machineroom/SCL4/DSA2IH00216994.pdf

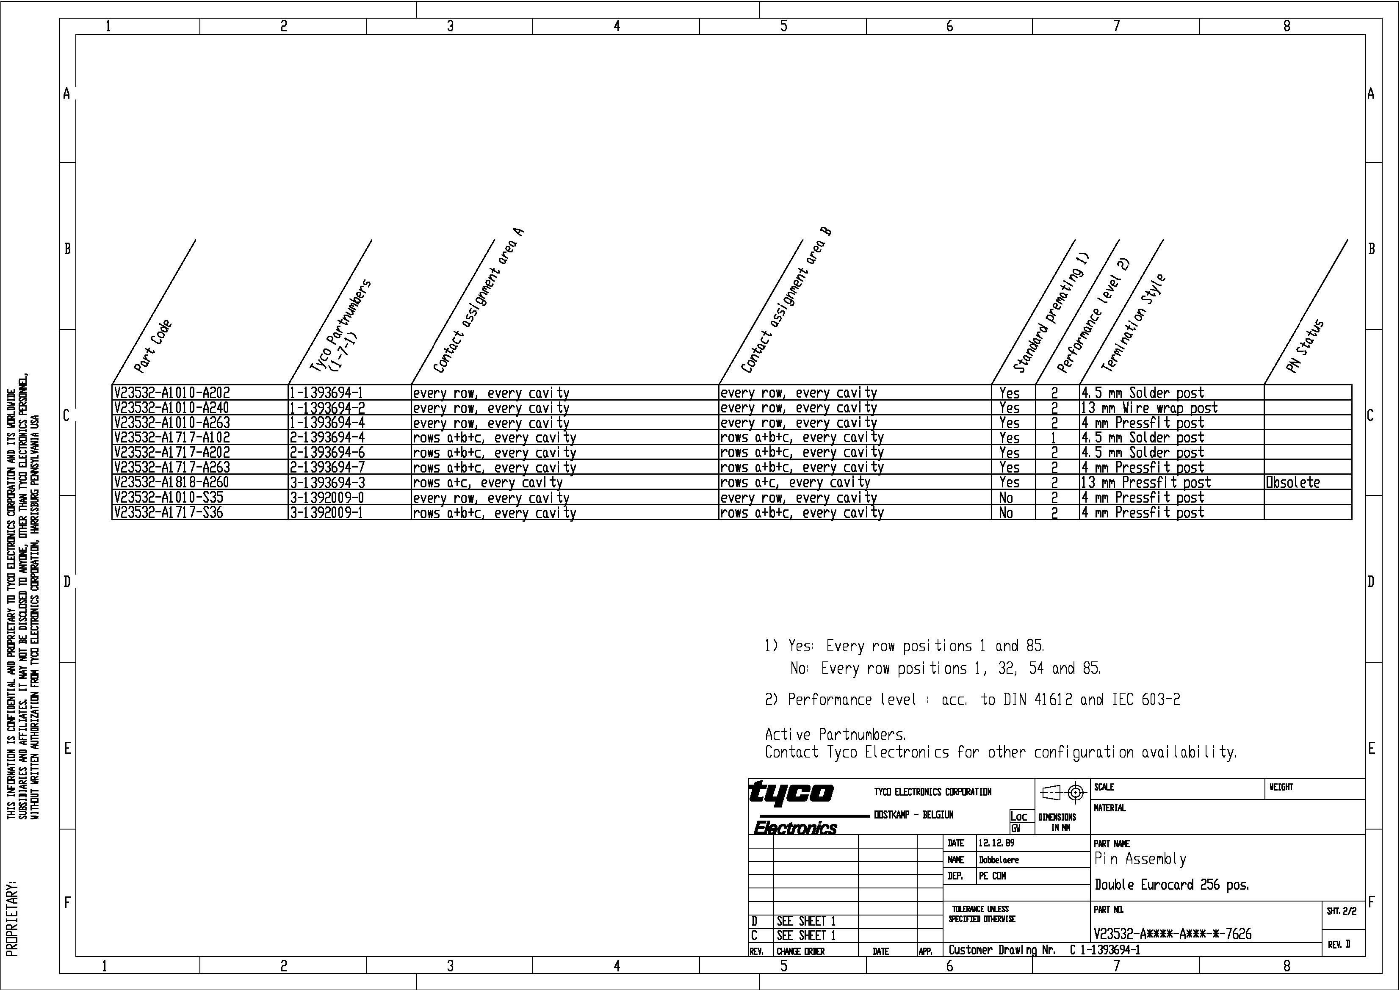
[picture p1: page 1]
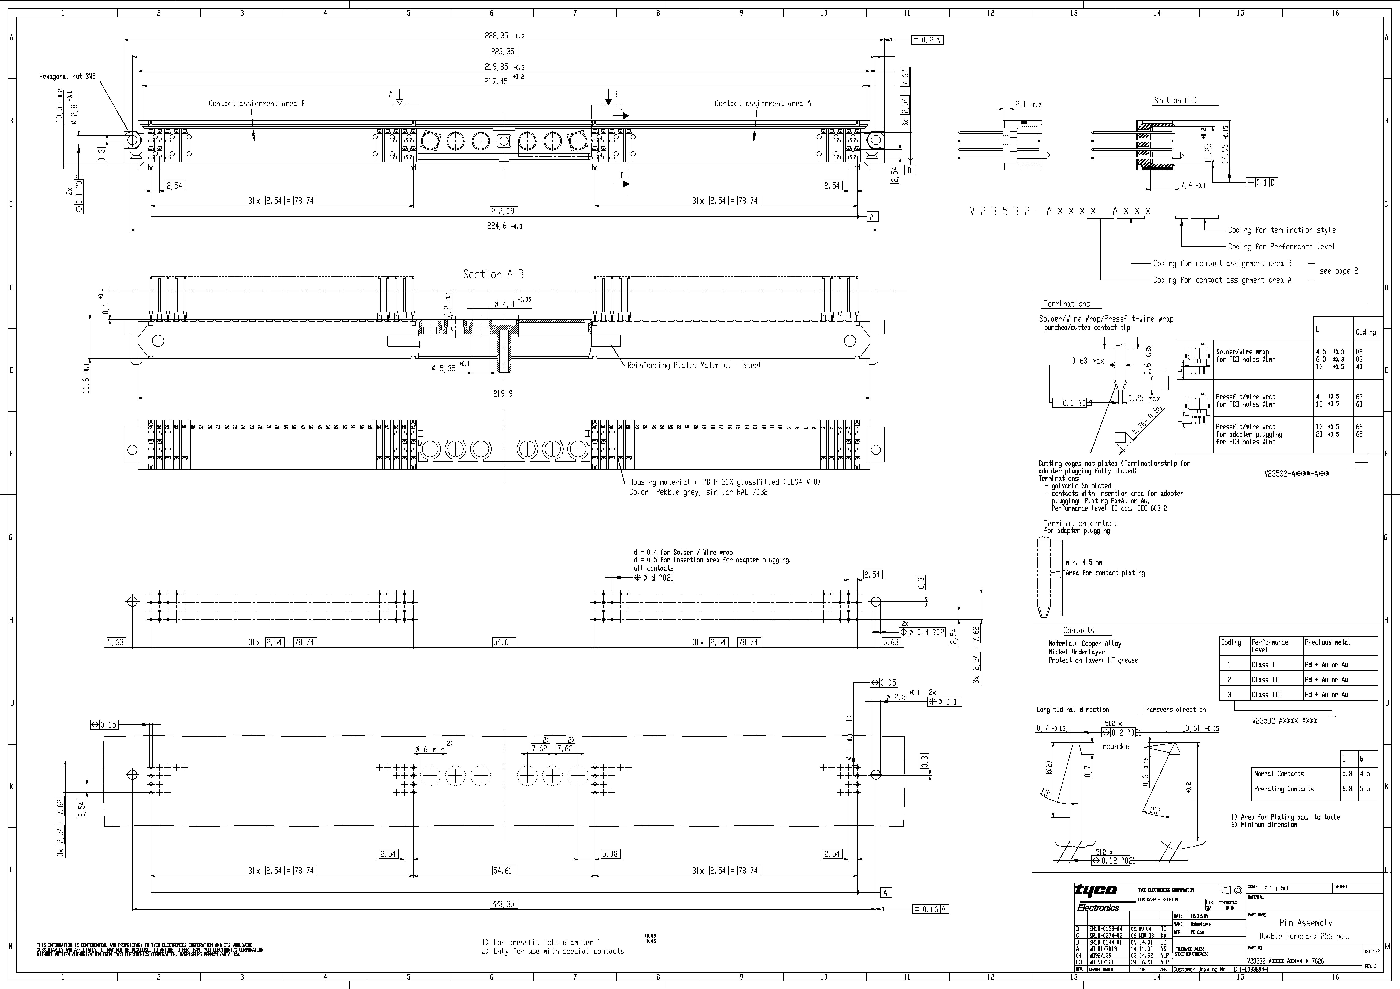
[picture p2: page 2]
