machineroom/SCL4/SCL4.kicad_pcb

## KiCad design SCL4.kicad_pcb (2023-01-14)

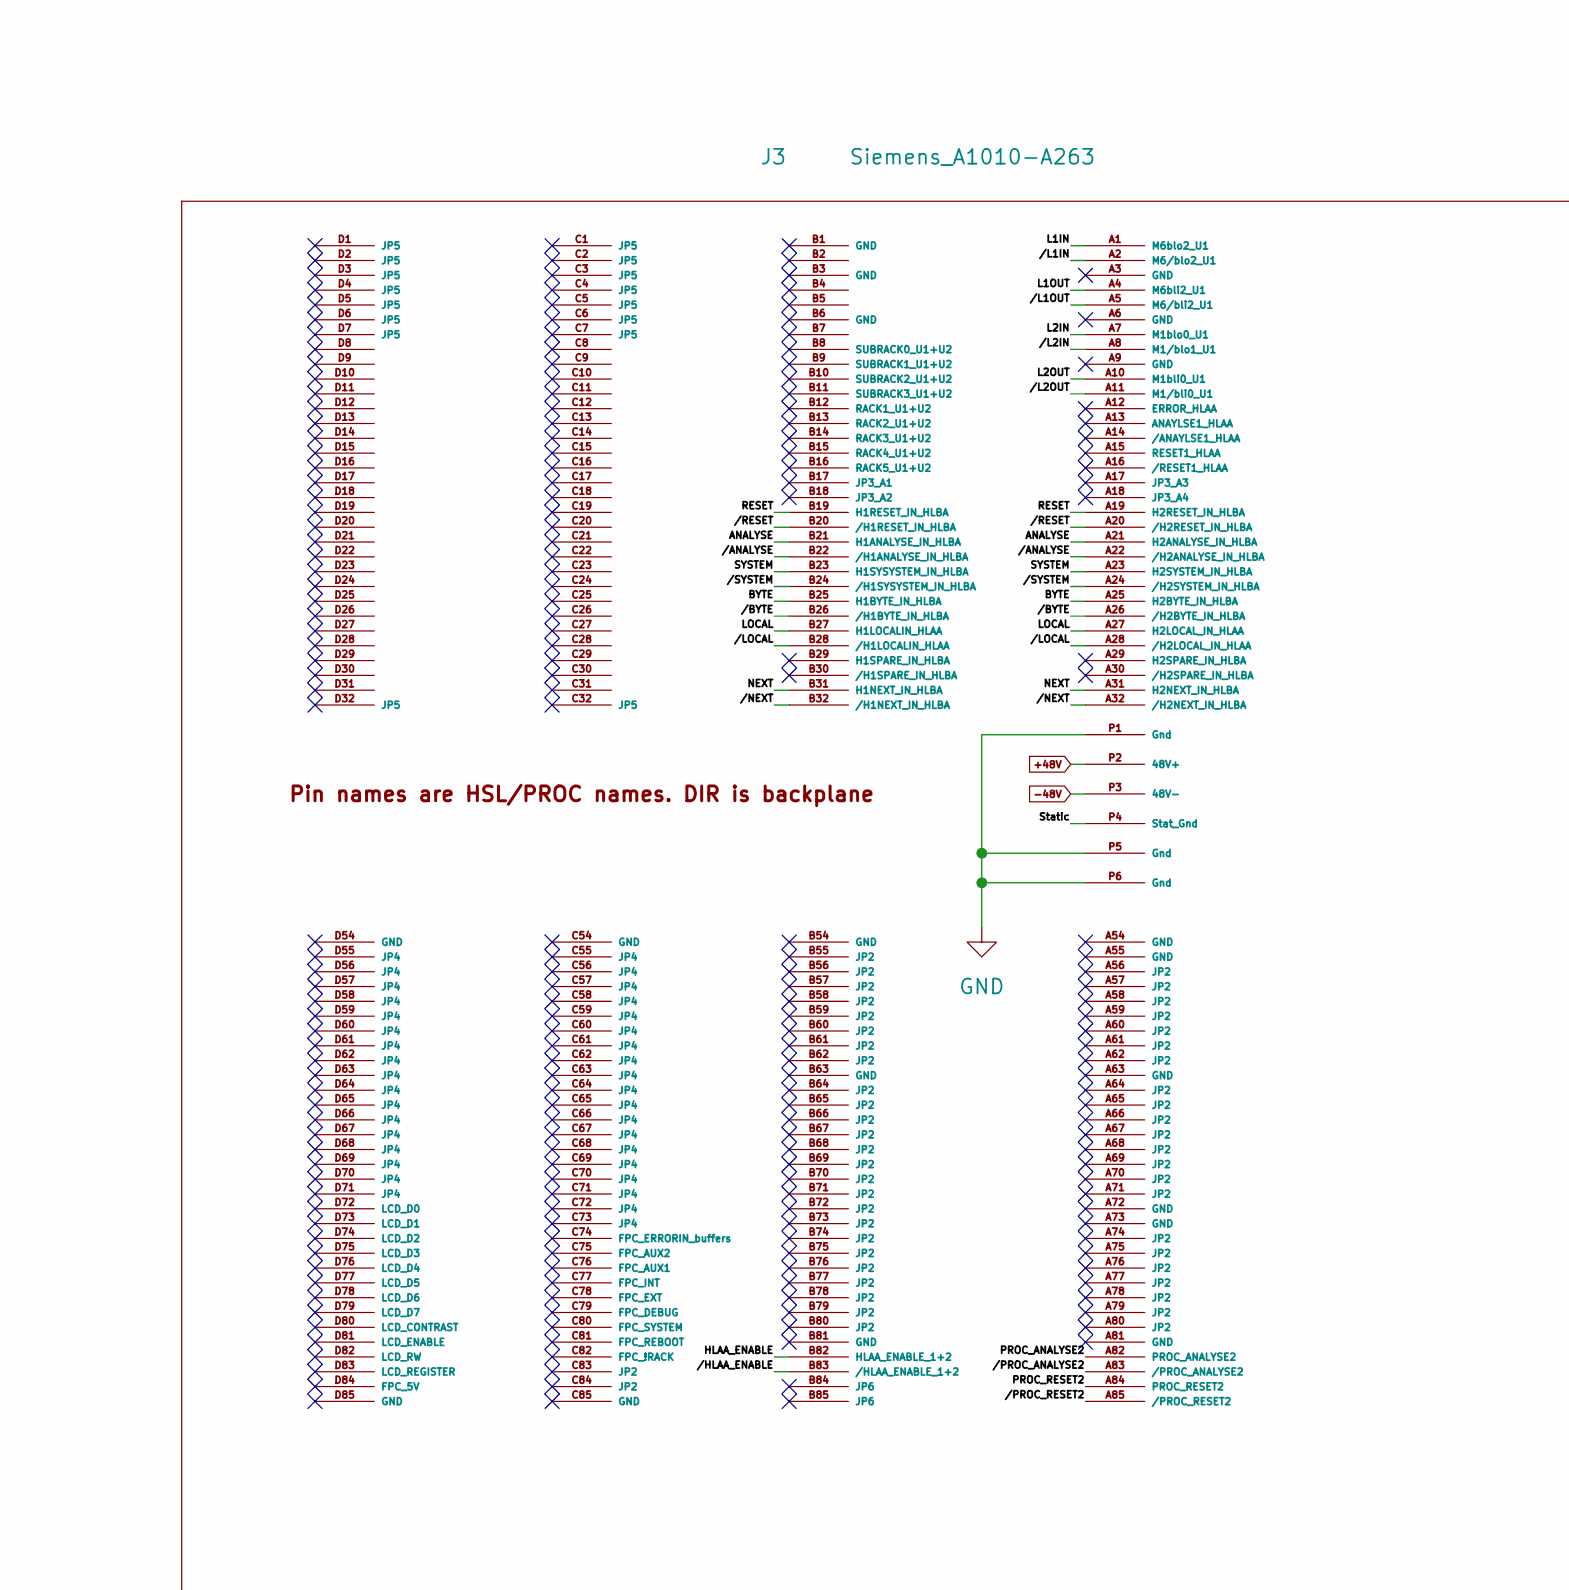
[picture p3: schematic SCL4.kicad_sch, part in row 1, column 1]

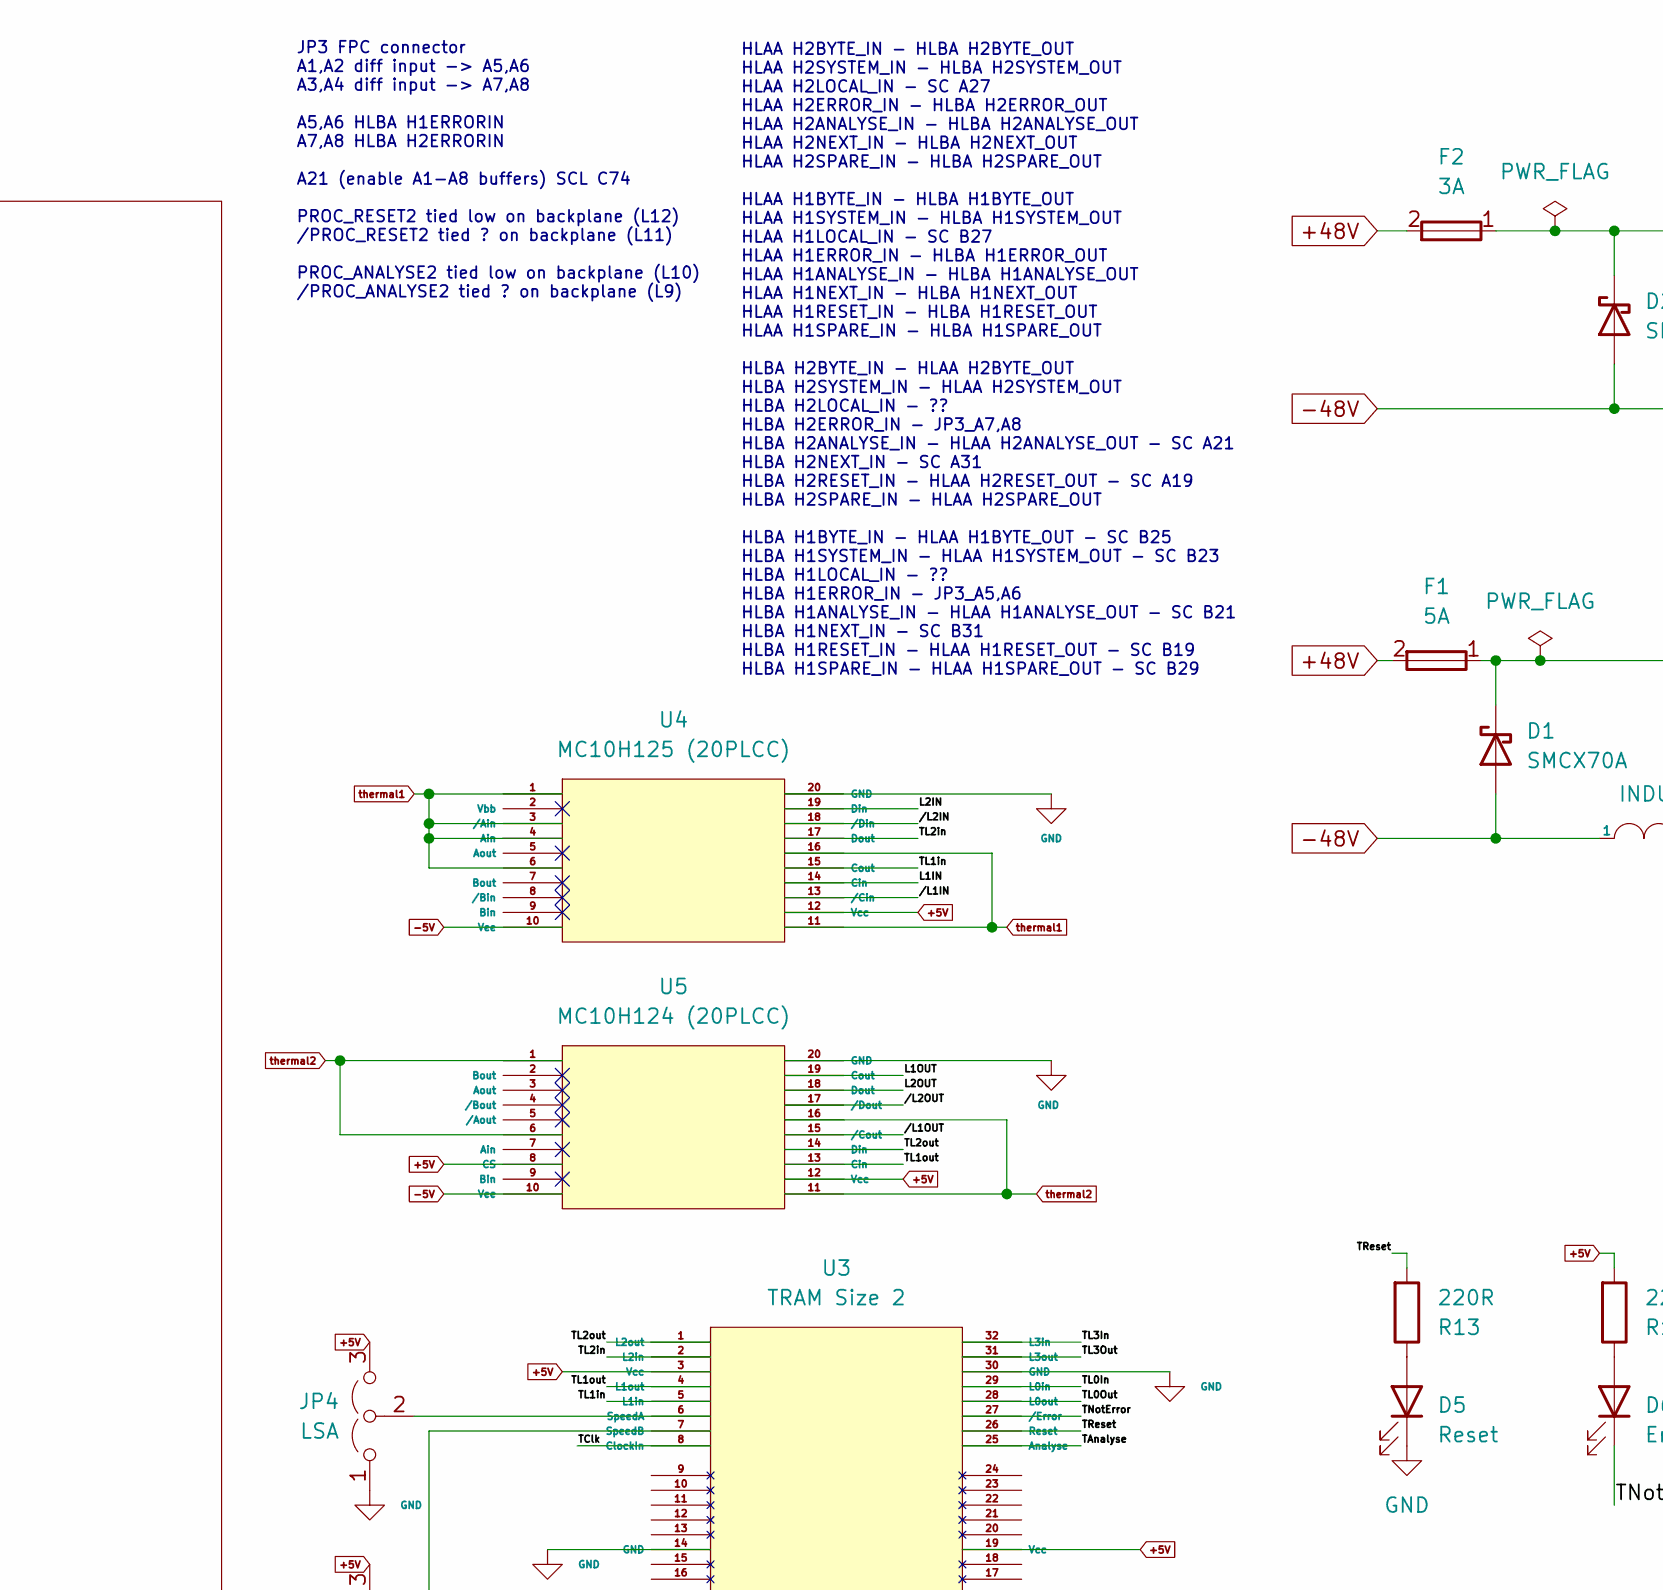
[picture p4: schematic SCL4.kicad_sch, part in row 1, column 2]

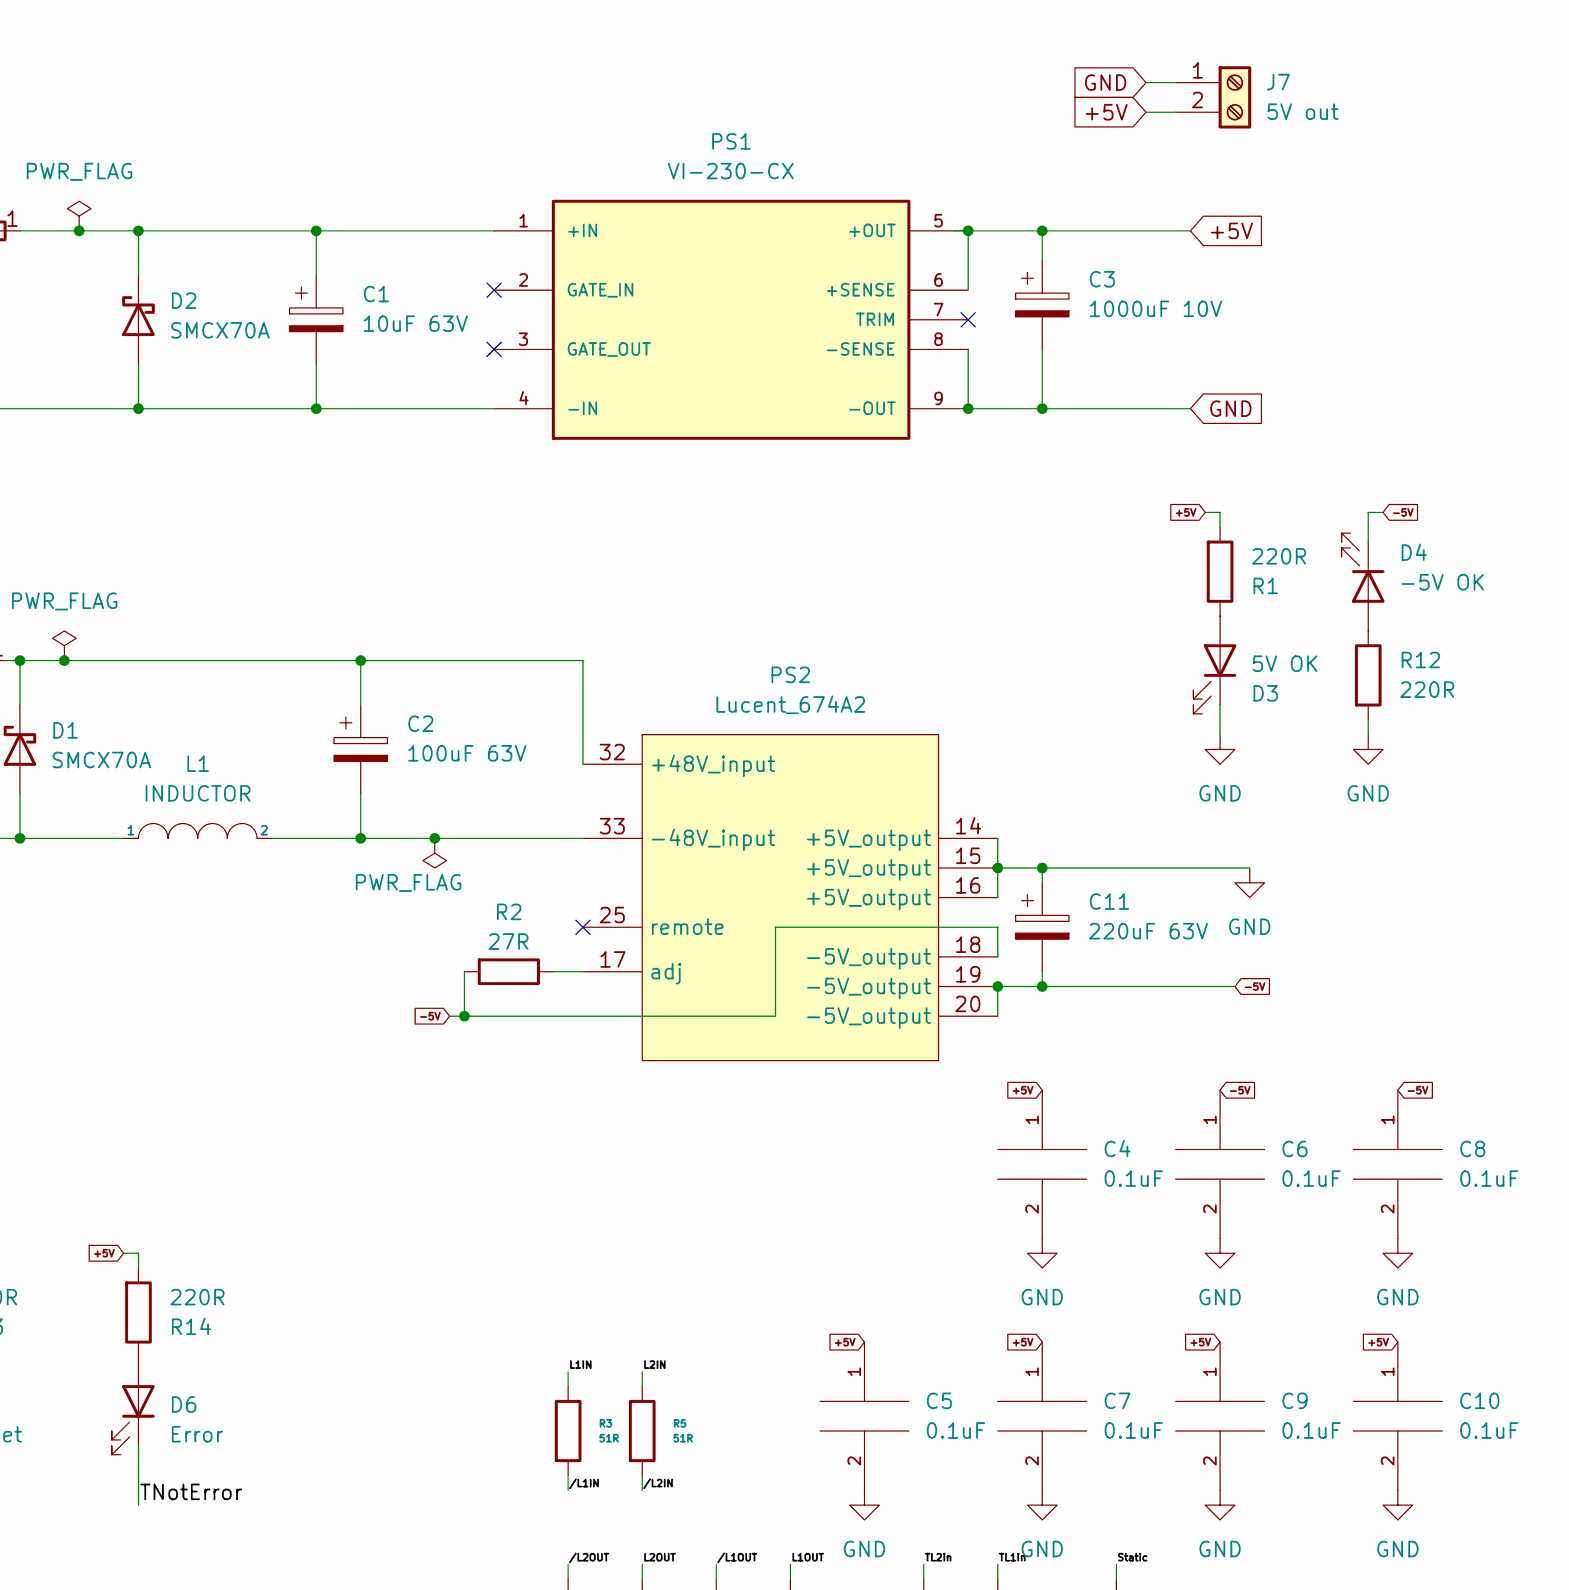
[picture p5: schematic SCL4.kicad_sch, part in row 1, column 3]

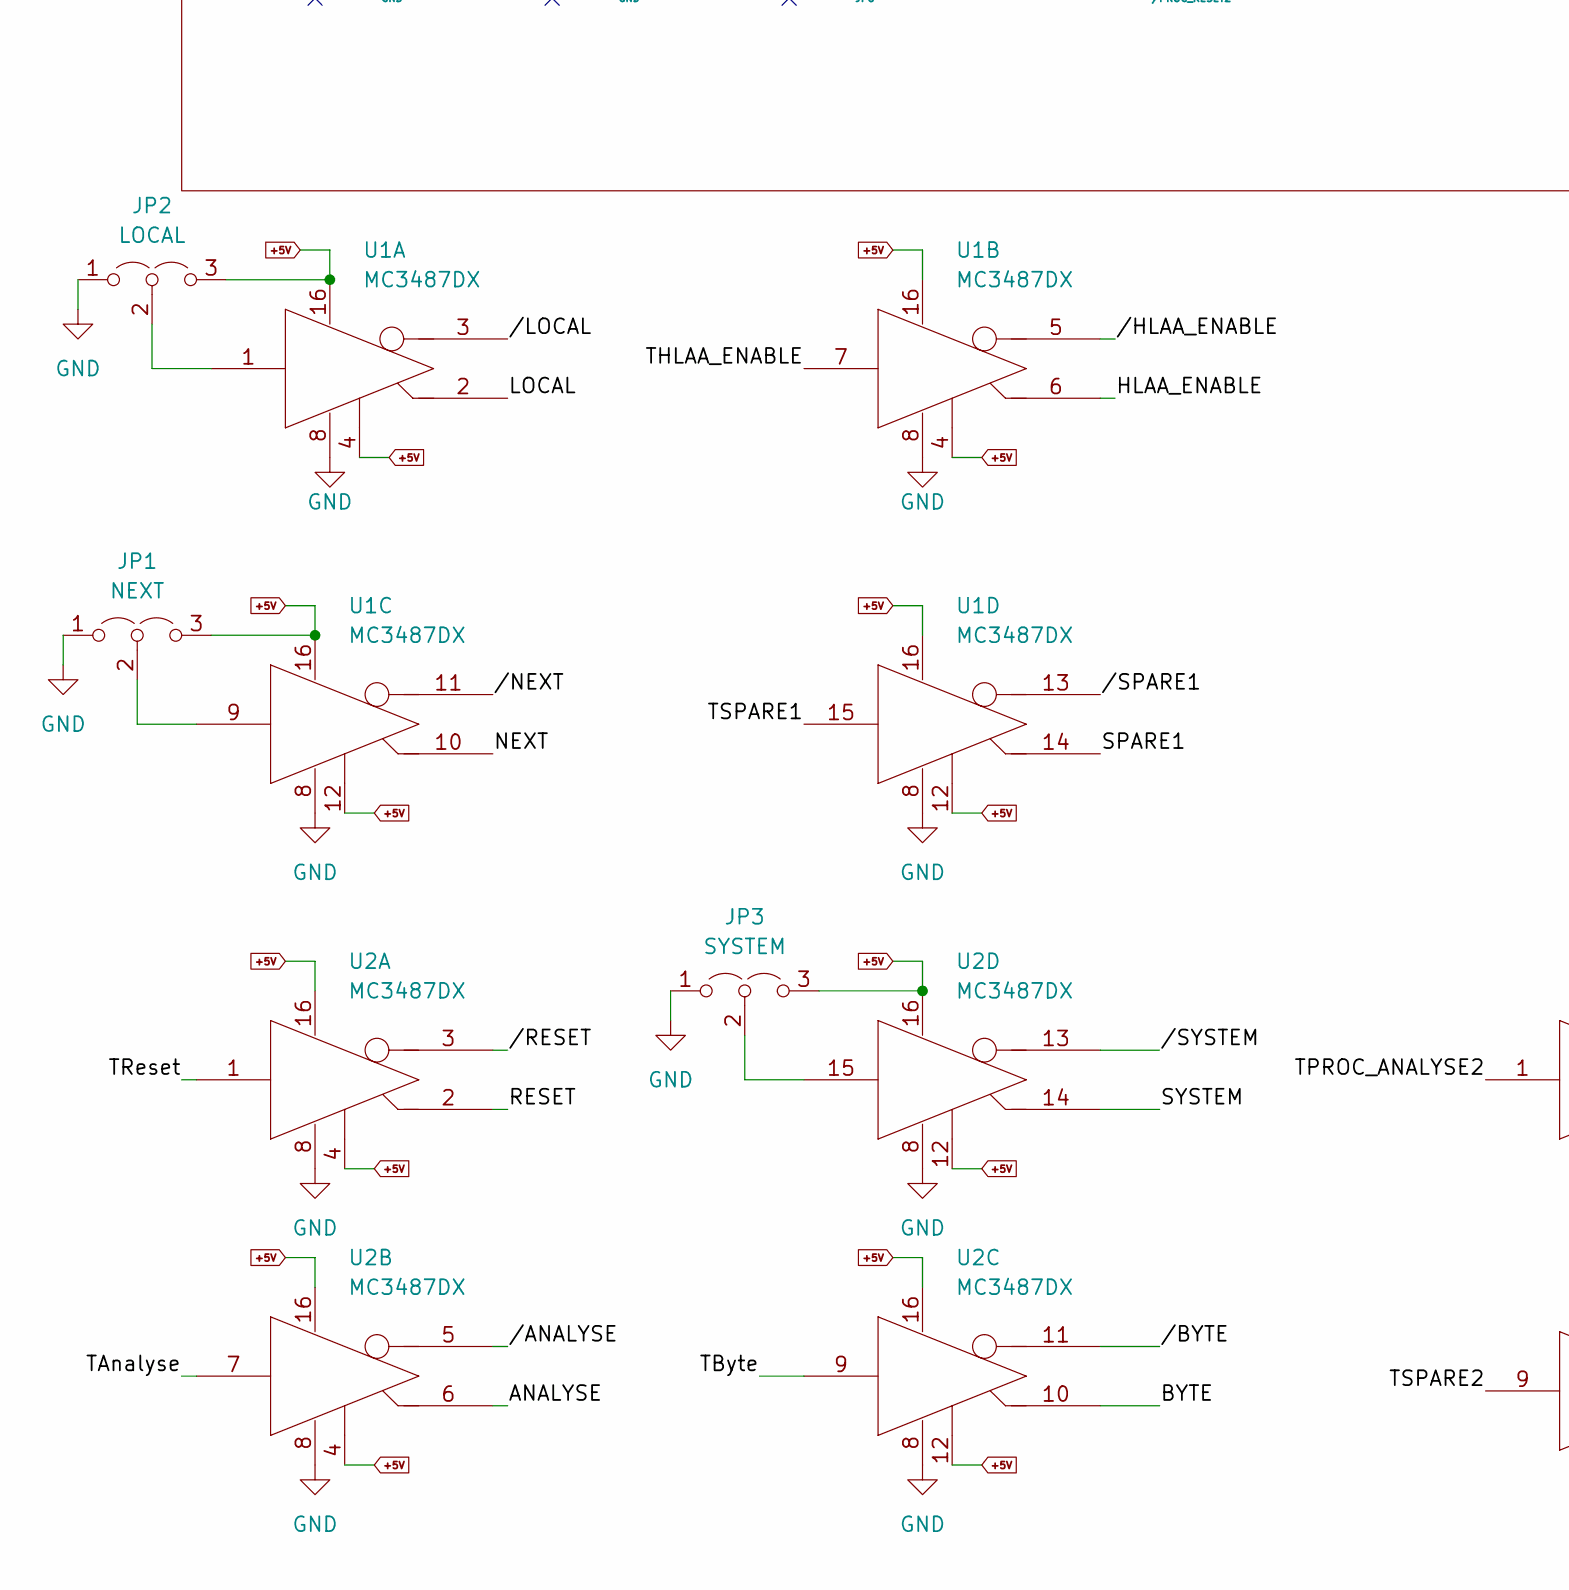
[picture p6: schematic SCL4.kicad_sch, part in row 2, column 1]

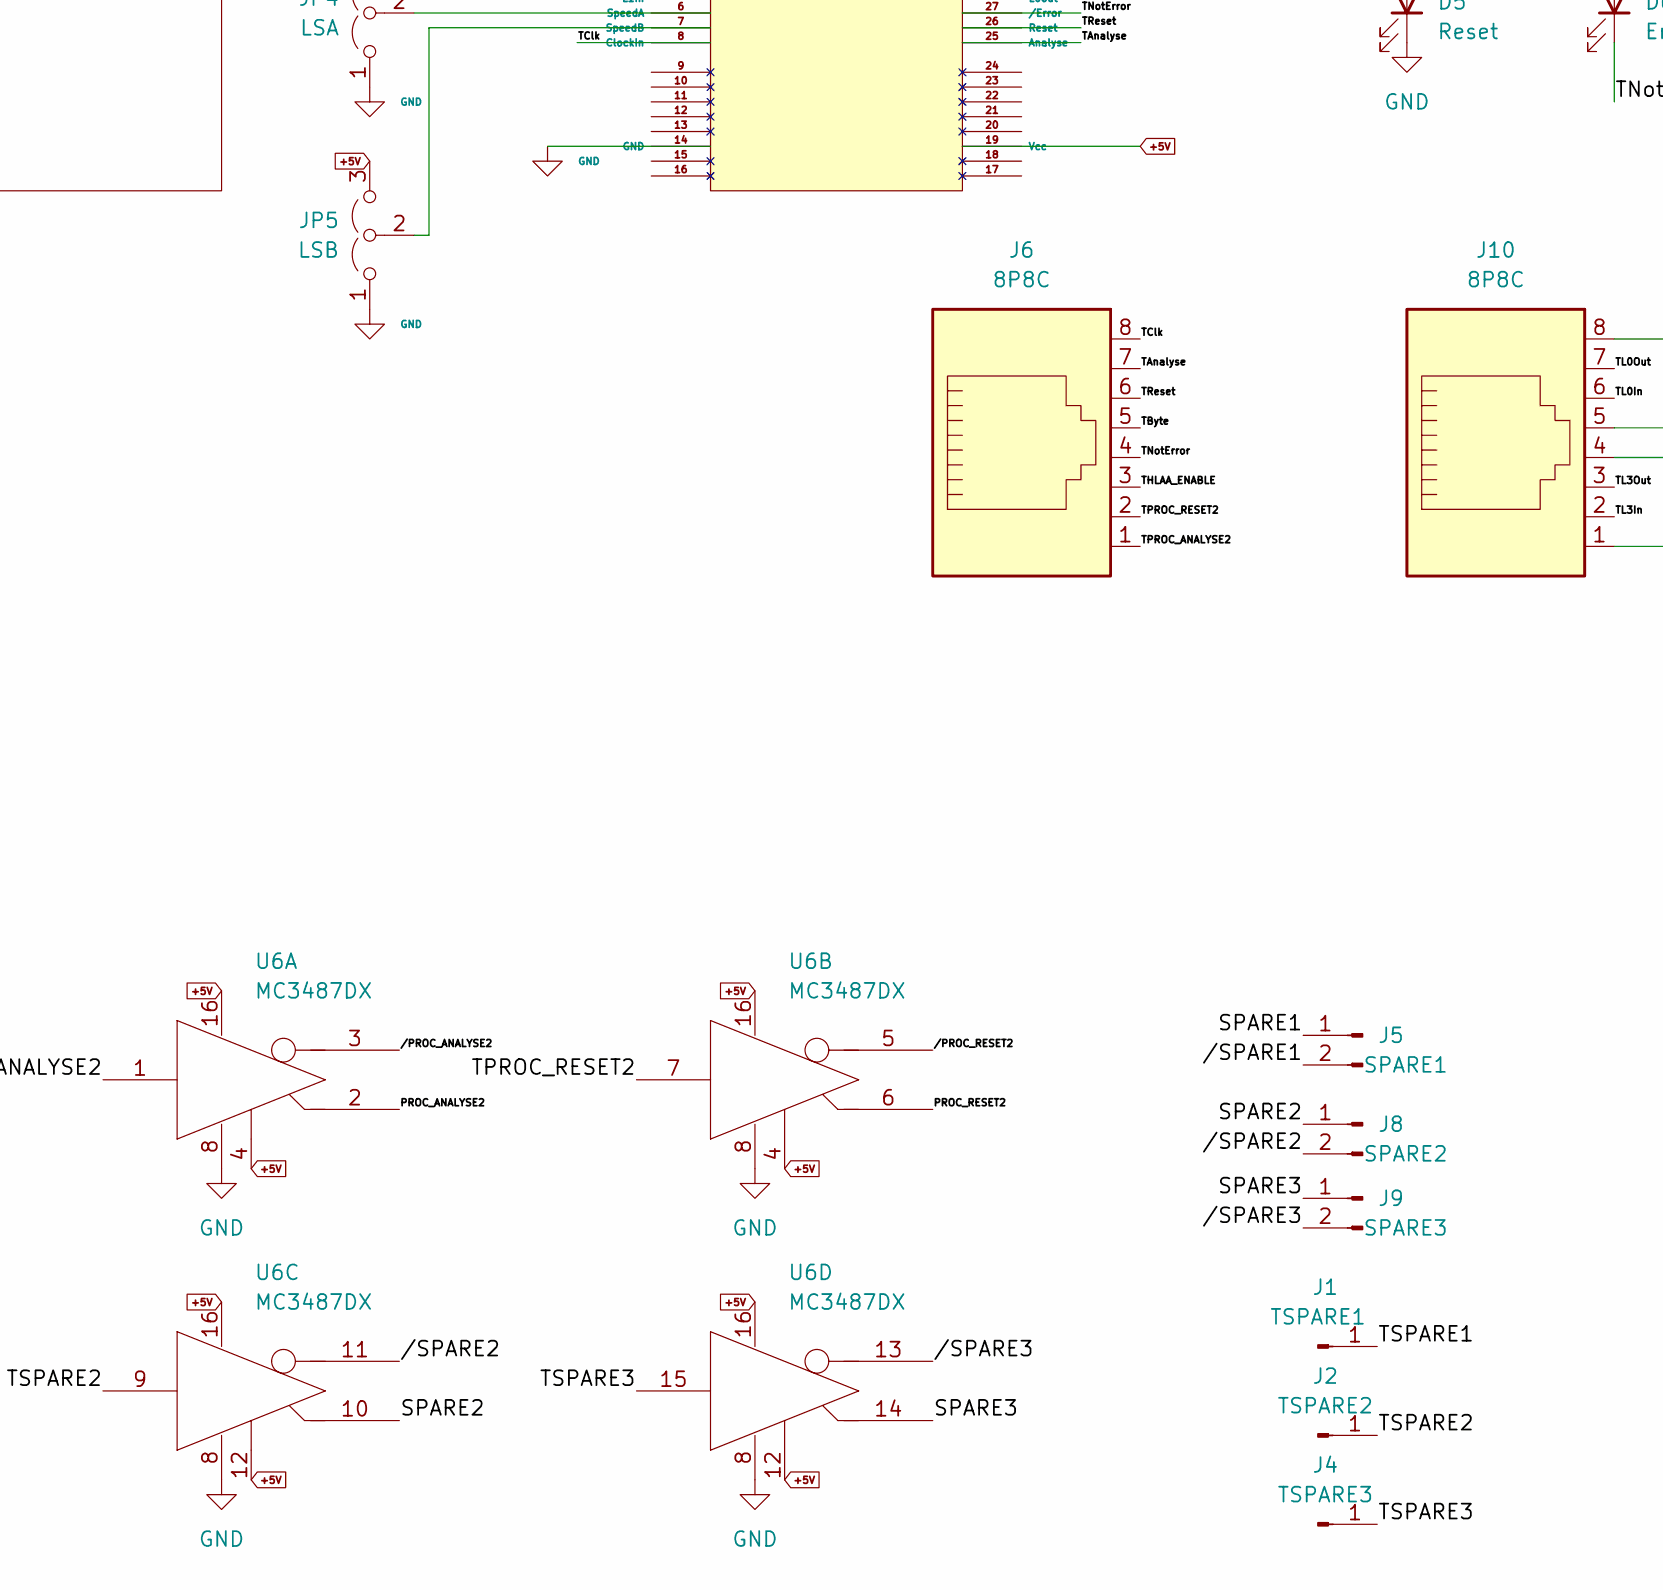
[picture p7: schematic SCL4.kicad_sch, part in row 2, column 2]

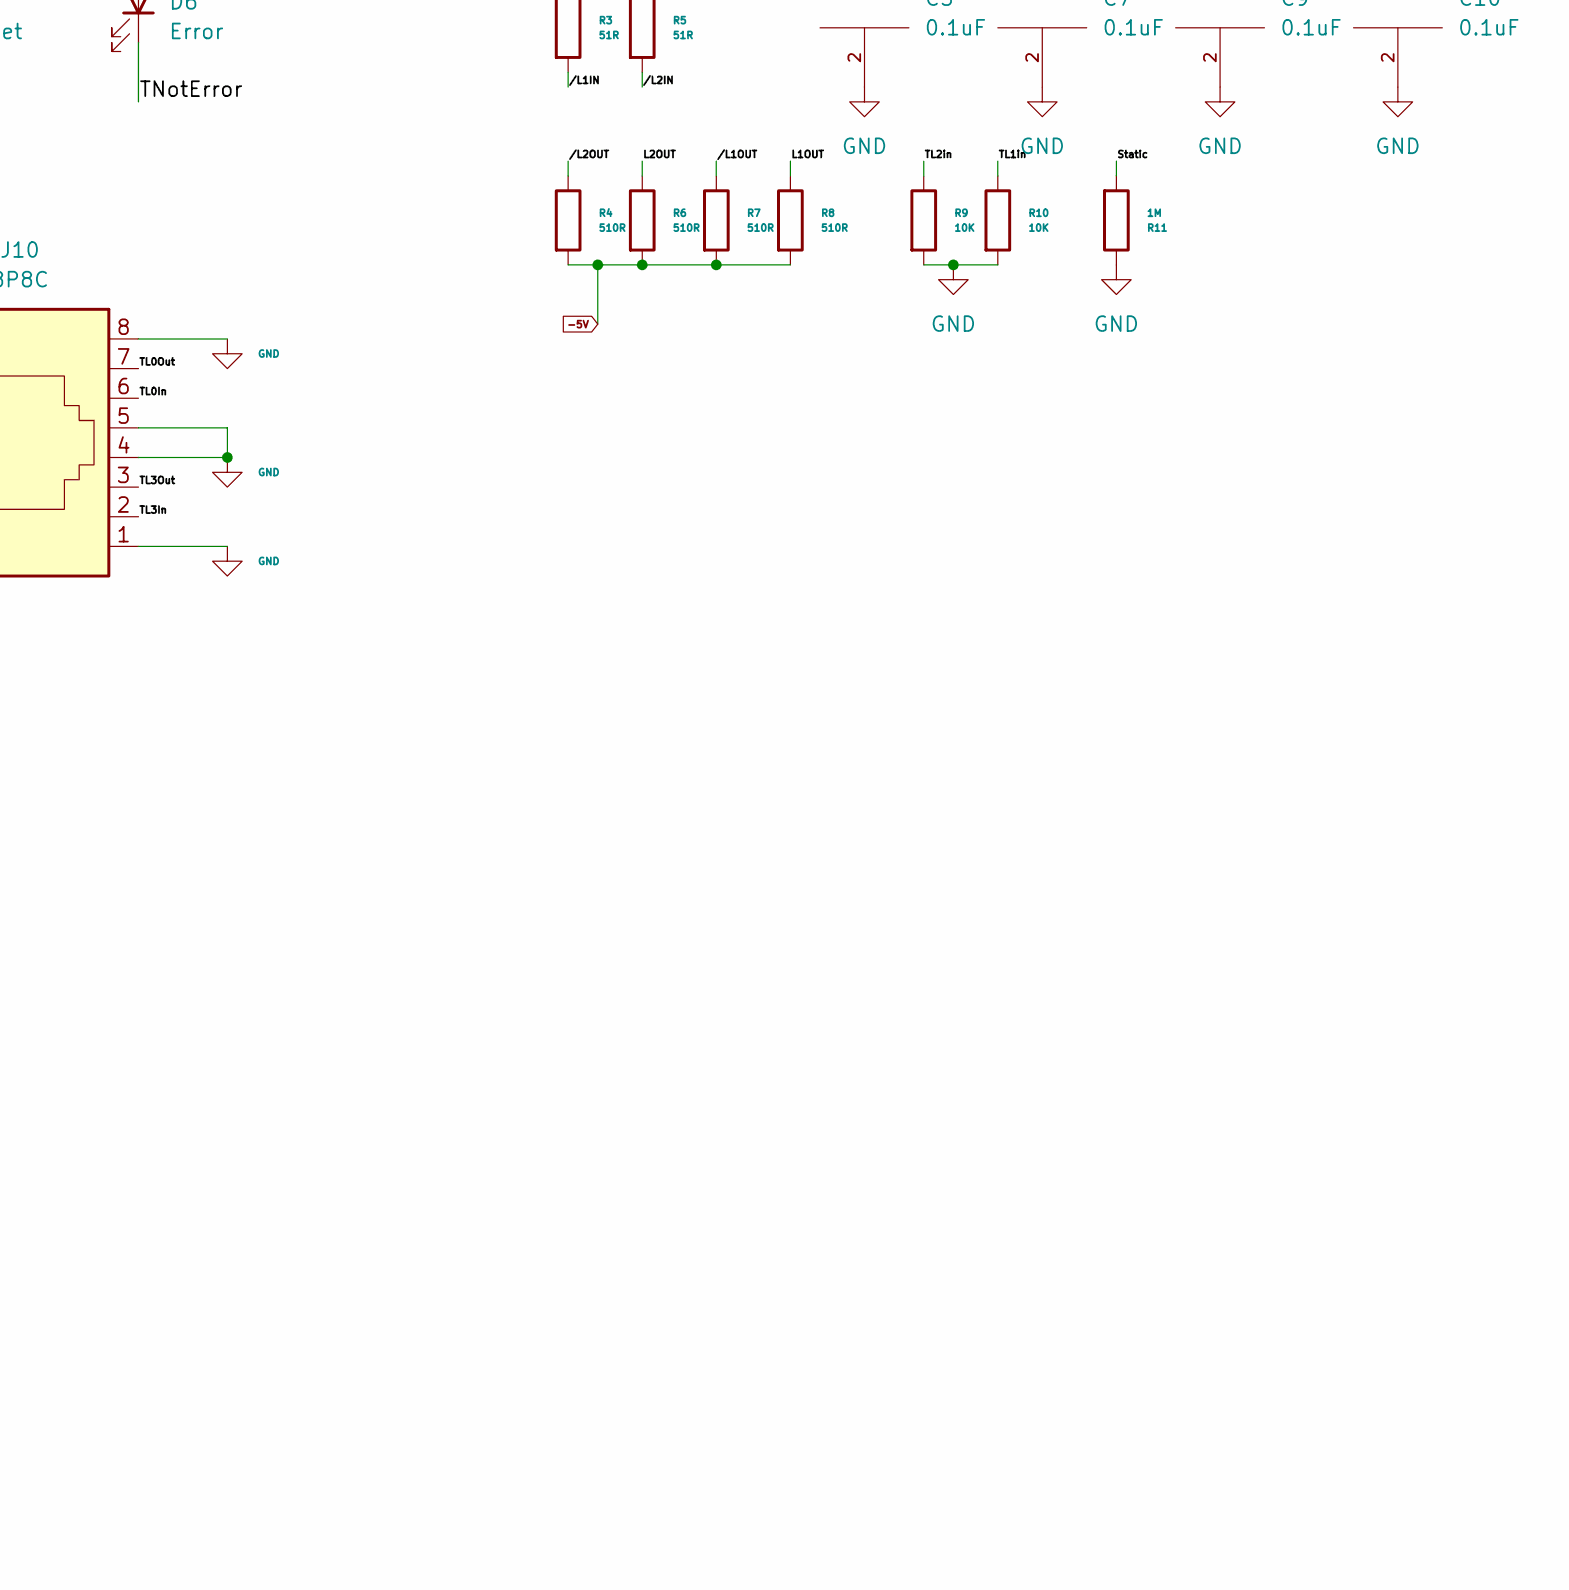
[picture p8: schematic SCL4.kicad_sch, part in row 2, column 3]

Parts:
C1: 10uF 63V; CP_Radial_D5.0mm_P2.50mm
C2: 100uF 63V; CP_Radial_D10.0mm_P5.00mm
C3: 1000uF 10V; C_Radial_D12.5mm_H20.0mm_P5.00mm
C4, C5, C6, C7, C8, C9, C10: 0.1uF; C_0402_1005Metric_Pad0.74x0.62mm_HandSolder
C11: 220uF 63V; C_Radial_D8.0mm_H11.5mm_P3.50mm
D1, D2: SMCX70A; D_SMC_Handsoldering
D3: 5V OK; LED_Rectangular_W5.0mm_H2.0mm
D4: -5V OK; LED_Rectangular_W5.0mm_H2.0mm
D5: Reset; LED_Rectangular_W5.0mm_H2.0mm
D6: Error; LED_Rectangular_W5.0mm_H2.0mm
F1: 5A; BUSSMAN SFT-1
F2: 3A; BUSSMAN SFT-1
J1: TSPARE1; PinHeader_1x01_P2.54mm_Vertical
J2: TSPARE2; PinHeader_1x01_P2.54mm_Vertical
J3: Siemens_A1010-A263; Siedecon 256+6
J4: TSPARE3; PinHeader_1x01_P2.54mm_Vertical
J5: SPARE1; PinHeader_1x02_P2.54mm_Vertical
J6, J10: 8P8C; RJ45_Ninigi_GE
J7: 5V out; TerminalBlock_bornier-2_P5.08mm
J8: SPARE2; PinHeader_1x02_P2.54mm_Vertical
J9: SPARE3; PinHeader_1x02_P2.54mm_Vertical
JP1: NEXT; PinHeader_1x03_P2.54mm_Vertical
JP2: LOCAL; PinHeader_1x03_P2.54mm_Vertical
JP3: SYSTEM; PinHeader_1x03_P2.54mm_Vertical
JP4: LSA; PinHeader_1x03_P2.54mm_Vertical
JP5: LSB; PinHeader_1x03_P2.54mm_Vertical
L1: INDUCTOR; L_Axial_L12.8mm_D5.8mm_P20.32mm_Horizontal_Fastron_HBCC
PS1: VI-230-CX; vicor vi230cx; PARTREV 3.9
PS2: Lucent_674A2; Lucent 674A2
R1, R12, R13, R14: 220R; R_1206_3216Metric_Pad1.30x1.75mm_HandSolder
R2: 27R; R_1206_3216Metric_Pad1.30x1.75mm_HandSolder
R3, R5: 51R; R_1206_3216Metric_Pad1.30x1.75mm_HandSolder
R4, R6, R7, R8: 510R; R_1206_3216Metric_Pad1.30x1.75mm_HandSolder
R9, R10: 10K; R_1206_3216Metric_Pad1.30x1.75mm_HandSolder
R11: 1M; R_1206_3216Metric_Pad1.30x1.75mm_HandSolder
U1, U2, U6: MC3487DX; SOIC-16_3.9x9.9mm_P1.27mm
U3: TRAM Size 2; TRAM size 2
U4: MC10H125 (20PLCC); PLCC-20
U5: MC10H124 (20PLCC); PLCC-20

Connections:
+5V: C3.1, C4.1, C5.1, C7.1, C9.1, C10.1, J7.2, JP1.3 (B), JP2.3 (B), JP3.3 (B), JP4.3 (B), JP5.3 (B), PS1.5 (+OUT), PS1.6 (+SENSE), R1.2, R14.2, U1.4 (ENABLE), U1.12 (ENABLE), U1.16 (VCC), U2.4 (ENABLE), U2.12 (ENABLE), U2.16 (VCC), U3.3 (Vcc), U3.19 (Vcc), U4.12 (Vcc), U5.8 (CS), U5.12 (Vcc), U6.4 (ENABLE), U6.12 (ENABLE), U6.16 (VCC)
+48V: F1.2, F2.2, J3.P2 (48V+)
-5V: C6.1, C8.1, C11.2, D4.1 (K), PS2.18 (-5V_output), PS2.19 (-5V_output), PS2.20 (-5V_output), R2.2, R4.2, R6.2, R7.2, R8.2, U4.10 (Vee), U5.10 (Vee)
-48V: C1.2, D1.2 (A), D2.2 (A), J3.P3 (48V-), L1.1, PS1.4 (-IN)
/ANALYSE: J3.A21 (H2ANALYSE_IN_HLBA), J3.B21 (H1ANALYSE_IN_HLBA), U2.6 (OUT+)
/BYTE: J3.A25 (H2BYTE_IN_HLBA), J3.B25 (H1BYTE_IN_HLBA), U2.10 (OUT+)
/HLAA_ENABLE: J3.B82 (HLAA_ENABLE_1+2), U1.6 (OUT+)
/L1IN: J3.A1 (M6blo2_U1), R3.1, U4.14 (Cin)
/L1OUT: J3.A4 (M6bli2_U1), R8.1, U5.19 (Cout)
/L2IN: J3.A7 (M1blo0_U1), R5.1, U4.19 (Din)
/L2OUT: J3.A10 (M1bli0_U1), R6.1, U5.18 (Dout)
/LOCAL: J3.A27 (H2LOCAL_IN_HLAA), J3.B27 (H1LOCALIN_HLAA), U1.2 (OUT+)
/NEXT: J3.A31 (H2NEXT_IN_HLBA), J3.B31 (H1NEXT_IN_HLBA), U1.10 (OUT+)
/PROC_ANALYSE2: J3.A82 (PROC_ANALYSE2), U6.2 (OUT+)
/PROC_RESET2: J3.A84 (PROC_RESET2), U6.6 (OUT+)
/RESET: J3.A19 (H2RESET_IN_HLBA), J3.B19 (H1RESET_IN_HLBA), U2.2 (OUT+)
/SPARE1: J5.1, U1.14 (OUT+)
/SPARE2: J8.1, U6.10 (OUT+)
/SPARE3: J9.1, U6.14 (OUT+)
/SYSTEM: J3.A23 (H2SYSTEM_IN_HLBA), J3.B23 (H1SYSYSTEM_IN_HLBA), U2.14 (OUT+)
/Static: J3.P4 (Stat_Gnd), R11.2
/TAnalyse: J6.7, U2.7 (INPUT), U3.25 (Analyse)
/TByte: J6.5, U2.9 (INPUT)
/TClk: J6.8, U3.8 (ClockIn)
/THLAA_ENABLE: J6.3, U1.7 (INPUT)
/TL0In: J10.6, U3.29 (L0in)
/TL0Out: J10.7, U3.28 (L0out)
/TL1in: R10.1, U3.5 (L1in), U4.15 (Cout)
/TL1out: U3.4 (L1out), U5.13 (Cin)
/TL2in: R9.1, U3.2 (L2in), U4.17 (Dout)
/TL2out: U3.1 (L2out), U5.14 (Din)
/TL3In: J10.2, U3.32 (L3in)
/TL3Out: J10.3, U3.31 (L3out)
/TNotError: D6.1 (K), J6.4, U3.27 (/Error)
/TPROC_ANALYSE2: J6.1, U6.1 (INPUT)
/TPROC_RESET2: J6.2, U6.7 (INPUT)
/TReset: J6.6, R13.2, U2.1 (INPUT), U3.26 (Reset)
/TSPARE1: J1.1, U1.15 (INPUT)
/TSPARE2: J2.1, U6.9 (INPUT)
/TSPARE3: J4.1, U6.15 (INPUT)
//ANALYSE: J3.A22 (/H2ANALYSE_IN_HLBA), J3.B22 (/H1ANALYSE_IN_HLBA), U2.5 (OUT-)
//BYTE: J3.A26 (/H2BYTE_IN_HLBA), J3.B26 (/H1BYTE_IN_HLBA), U2.11 (OUT-)
//HLAA_ENABLE: J3.B83 (/HLAA_ENABLE_1+2), U1.5 (OUT-)
//L1IN: J3.A2 (M6/blo2_U1), R3.2, U4.13 (/Cin)
//L1OUT: J3.A5 (M6/bli2_U1), R7.1, U5.15 (/Cout)
//L2IN: J3.A8 (M1/blo1_U1), R5.2, U4.18 (/Din)
//L2OUT: J3.A11 (M1/bli0_U1), R4.1, U5.17 (/Dout)
//LOCAL: J3.A28 (/H2LOCAL_IN_HLAA), J3.B28 (/H1LOCALIN_HLAA), U1.3 (OUT-)
//NEXT: J3.A32 (/H2NEXT_IN_HLBA), J3.B32 (/H1NEXT_IN_HLBA), U1.11 (OUT-)
//PROC_ANALYSE2: J3.A83 (/PROC_ANALYSE2), U6.3 (OUT-)
//PROC_RESET2: J3.A85 (/PROC_RESET2), U6.5 (OUT-)
//RESET: J3.A20 (/H2RESET_IN_HLBA), J3.B20 (/H1RESET_IN_HLBA), U2.3 (OUT-)
//SPARE1: J5.2, U1.13 (OUT-)
//SPARE2: J8.2, U6.11 (OUT-)
//SPARE3: J9.2, U6.13 (OUT-)
//SYSTEM: J3.A24 (/H2SYSTEM_IN_HLBA), J3.B24 (/H1SYSYSTEM_IN_HLBA), U2.13 (OUT-)
GND: C3.2, C4.2, C5.2, C6.2, C7.2, C8.2, C9.2, C10.2, C11.1, D3.1 (K), D5.1 (K), J3.P1 (Gnd), J3.P5 (Gnd), J3.P6 (Gnd), J7.1, J10.1, J10.4, J10.5, J10.8, JP1.1 (A), JP2.1 (A), JP3.1 (A), JP4.1 (A), JP5.1 (A), PS1.8 (-SENSE), PS1.9 (-OUT), PS2.14 (+5V_output), PS2.15 (+5V_output), PS2.16 (+5V_output), R9.2, R10.2, R11.1, R12.2, U1.8 (GND), U2.8 (GND), U3.14 (GND), U3.30 (GND), U4.20 (GND), U5.20 (GND), U6.8 (GND)
unnamed: C1.1, D2.1 (K), F2.1, PS1.1 (+IN)
unnamed: C2.1, D1.1 (K), F1.1, PS2.32 (+48V_input)
unnamed: C2.2, L1.2, PS2.33 (-48V_input)
unnamed: D3.2 (A), R1.1
unnamed: D4.2 (A), R12.1
unnamed: D5.2 (A), R13.1
unnamed: D6.2 (A), R14.1
unnamed: JP1.2 (C), U1.9 (INPUT)
unnamed: JP2.2 (C), U1.1 (INPUT)
unnamed: JP3.2 (C), U2.15 (INPUT)
unnamed: JP4.2 (C), U3.6 (SpeedA)
unnamed: JP5.2 (C), U3.7 (SpeedB)
unnamed: PS2.17 (adj), R2.1
thermal1: U4.1, U4.3 (/Ain), U4.4 (Ain), U4.6, U4.11, U4.16
thermal2: U5.1, U5.6, U5.11, U5.16

Notes on the sheet:
JP3 FPC connector A1,A2 diff input -> A5,A6 A3,A4 diff input -> A7,A8 A5,A6 HLBA H1ERRORIN A7,A8 HLBA H2ERRORIN A21 (enable A1-A8 buffers) SCL C74 PROC_RESET2 tied low on backplane (L12) /PROC_RESET2 tied ? on backplane (L11) PROC_ANALYSE2 tied low on backplane (L10) /PROC_ANALYSE2 tied ? on backpl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
HLAA H2BYTE_IN - HLBA H2BYTE_OUT HLAA H2SYSTEM_IN - HLBA H2SYSTEM_OUT HLAA H2LOCAL_IN - SC A27 HLAA H2ERROR_IN - HLBA H2ERROR_OUT HLAA H2ANALYSE_IN - HLBA H2ANALYSE_OUT HLAA H2NEXT_IN - HLBA H2NEXT_OUT HLAA H2SPARE_IN - HLBA H2SPARE_OUT HLAA H1BYTE_IN - HLBA H1BYTE_OUT HLAA H1SYSTEM_IN - HLBA H1SYS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

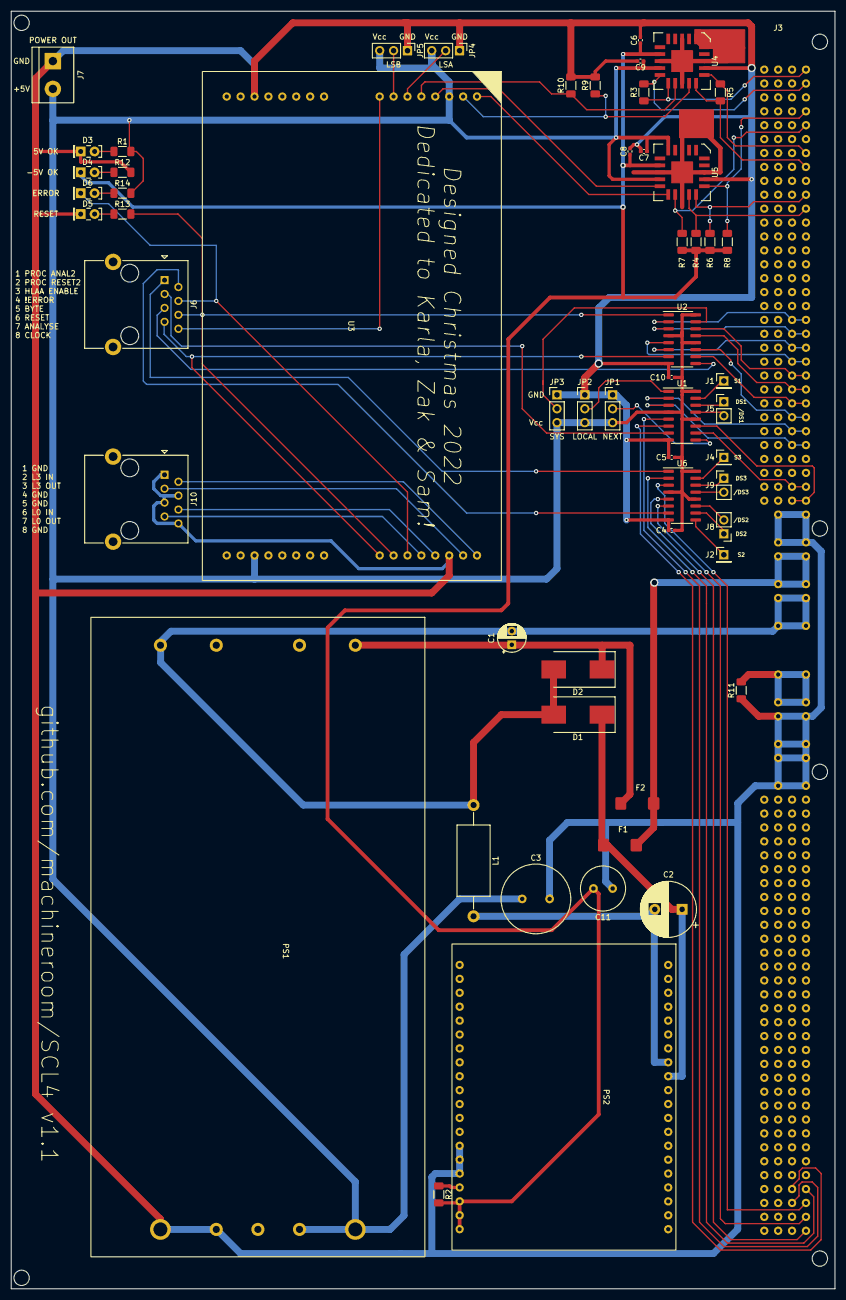
[picture p9: board SCL4.kicad_pcb from above]

Board: 2 copper layers, 150.5 x 233.3 mm, 57 parts (0 on the bottom side), 72 nets.
