machineroom/SCL4/(commit log)

2022-09-24 ERC passes
    [SCL4.kicad_sch]
2022-09-25 swap abcd on siedecon
    [SCL4.kicad_pcb, SCL4.kicad_sch]
2022-09-25 footprint for TRAM and siedecon
2022-09-25 fp assignment
    [SCL4.kicad_sch]
2022-09-25 odd ball SMD fuses
2022-09-25 starting routing
    [SCL4.kicad_pcb, SCL4.kicad_sch]
2022-10-09 board layout complete
    [SCL4.kicad_pcb, SCL4.kicad_sch]
2022-10-09 fix static gnd pin
    [SCL4.kicad_pcb, SCL4.kicad_sch]
2022-10-15 fix pin numbering of vicor
    [SCL4.kicad_pcb]
2022-10-15 correct differential orientation
    [SCL4.kicad_pcb, SCL4.kicad_sch]
2022-10-15 fixup tram pin spacing
    [SCL4.kicad_pcb, SCL4.kicad_sch]
2022-10-15 correct pin spacing of vi230cx
    [SCL4.kicad_pcb]
2022-10-16 Correct silkscreen labels
    [SCL4.kicad_pcb]
2022-10-16 update 256pin connector
    [SCL4.kicad_pcb, SCL4.kicad_sch]
2022-10-16 set output dir
    [SCL4.kicad_pcb]
2022-10-22 more SCL pins named
    [SCL4.kicad_sch]
2022-11-11 Add HLAA enable jumper
    [SCL4.kicad_pcb, SCL4.kicad_sch]
2022-12-31 Major rework - fix -5V2 PSU orientation - analyse2 & reset2 signals for proc only operation (no HSL) - bring TRAM L1 and L3 to external header - lay down C3 to reduce height - decoupling - reduce + b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
    [SCL4.kicad_pcb, SCL4.kicad_sch]
2023-01-01 Use RJ45 external and add thermal pads
    [SCL4.kicad_pcb, SCL4.kicad_sch]
2023-01-01 Add extraction holes
    [SCL4.kicad_pcb]
2023-01-01 more LEDs
    [SCL4.kicad_pcb, SCL4.kicad_sch]
2023-01-14 fix pins for -5V calibration R
    [SCL4.kicad_pcb, SCL4.kicad_sch]
